weizenyang/3RVX/3d-models/threshold-slope/images/segment_end.png

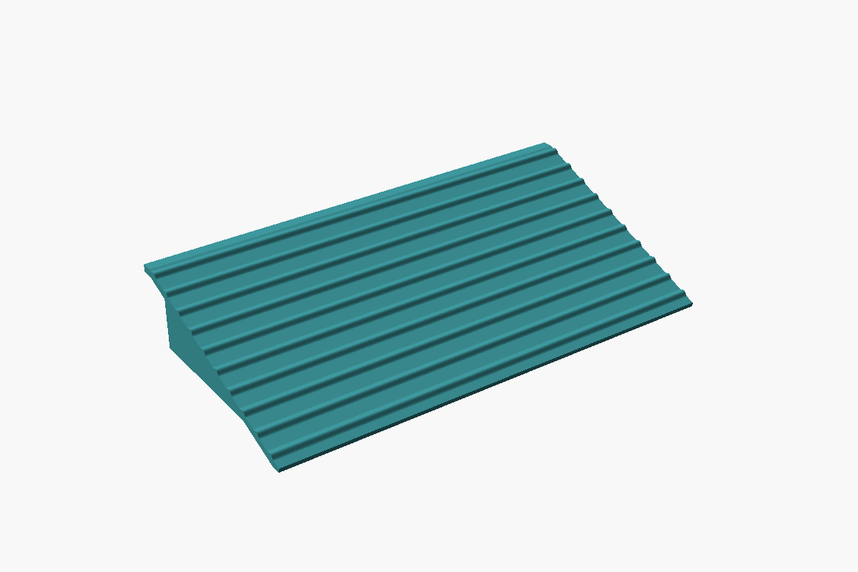
3d-models/threshold-slope/images/segment_end.png
