weizenyang/3RVX/3d-models/threshold-slope/images/segment_underside.png

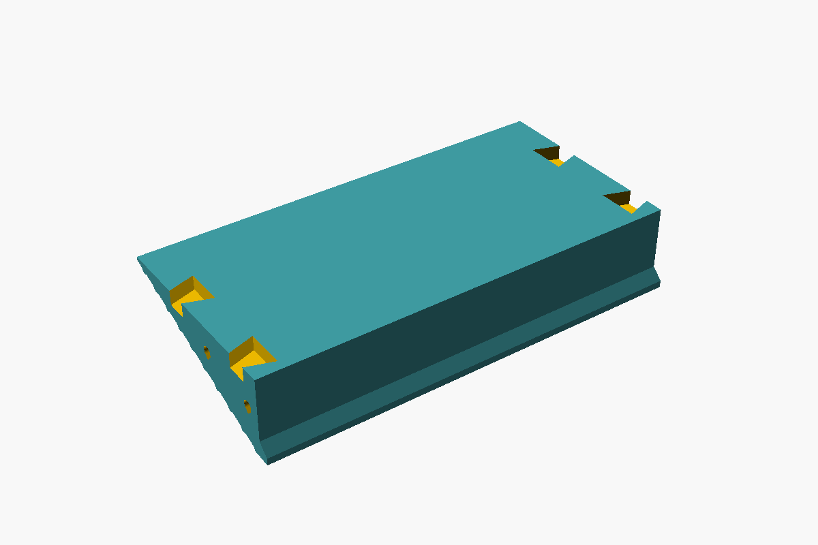
3d-models/threshold-slope/images/segment_underside.png
