weizenyang/3RVX/3d-models/threshold-slope/stl/3-segments/segment_2_of_3.stl

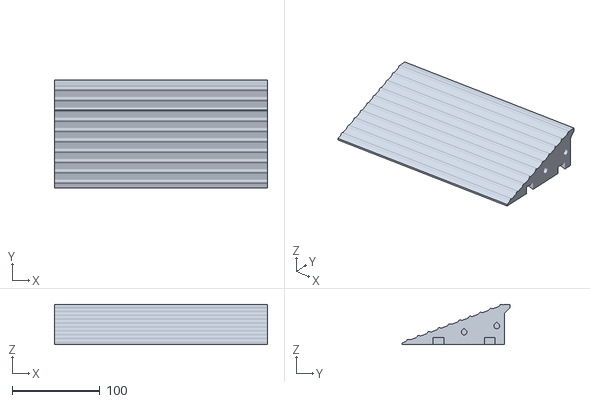
[picture p5: CAD file, 2026-10-03]
3d-models/threshold-slope/stl/3-segments/segment_2_of_3.stl
243.0 x 123.0 x 46.0
