weizenyang/3RVX/3d-models/threshold-slope/stl/3-segments/keys_and_pins.stl

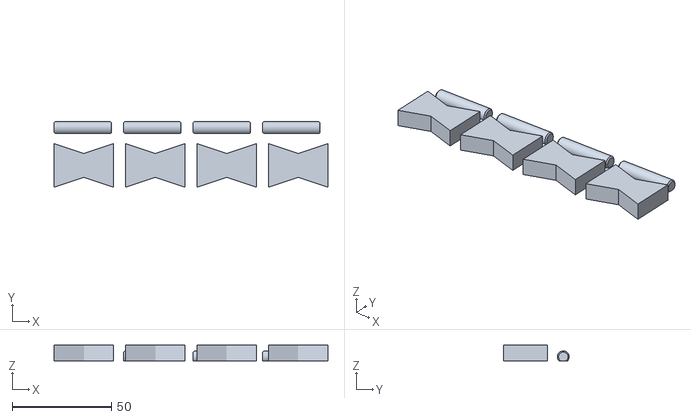
[picture p7: CAD file, 2026-10-03]
3d-models/threshold-slope/stl/3-segments/keys_and_pins.stl
138.0 x 33.0 x 8.00
