weizenyang/3RVX/3d-models/threshold-slope/stl/4-segments/segment_2_of_4.stl

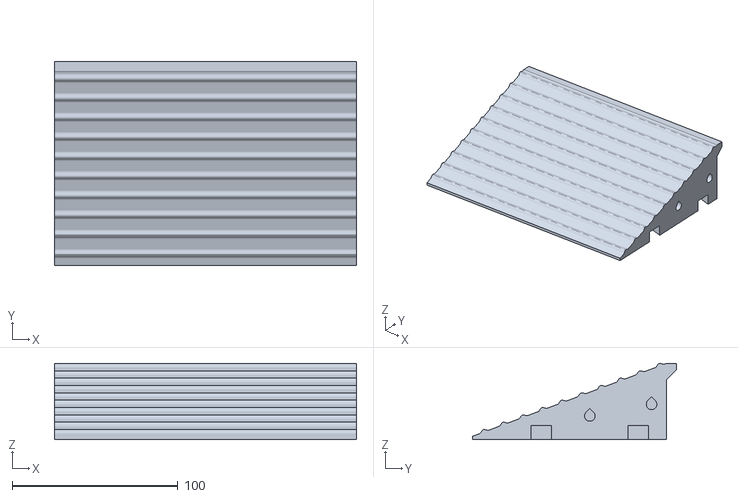
[picture p8: CAD file, 2026-10-03]
3d-models/threshold-slope/stl/4-segments/segment_2_of_4.stl
182.2 x 123.0 x 46.0
