weizenyang/3RVX/3d-models/threshold-slope/stl/4-segments/keys_and_pins.stl

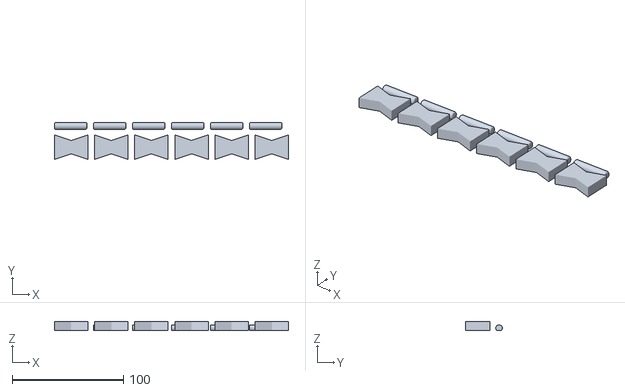
[picture p10: CAD file, 2026-10-03]
3d-models/threshold-slope/stl/4-segments/keys_and_pins.stl
210.0 x 33.0 x 8.00
