weizenyang/3RVX/(list of files, cad)

Other CAD files:
3d-models/threshold-slope/stl/3-segments/segment_3_of_3.stl
3d-models/threshold-slope/stl/4-segments/segment_3_of_4.stl
3d-models/threshold-slope/stl/4-segments/segment_1_of_4.stl
