weizenyang/3RVX/(commit log)

2026-10-03 Add printable 723x120x46 mm threshold slope with wall scribe lips
    Parametric OpenSCAD model of a wedge ramp that slopes down across its
    120 mm depth. The left, right and back sides get a 45-degree chamfered
    scribe lip that overhangs the nominal wall line by 3 mm for trimming to
    uneven walls, with the body held 3 mm off each wall.
    The 723 mm length is split into 3 (250 mm beds) or 4 (220 mm beds)
    segments joined by glued bow-tie keys and teardrop-hole alignment pins.
    Includes exported STLs, preview images, a build script, and print,
    fitting and load notes.
    Claude-Session: https://claude.ai/code/session_01UUmAX72UCkmaHZkJJaWWWV
    [keys_and_pins.stl, segment_1_of_3.stl, segment_1_of_4.stl, segment_2_of_3.stl, segment_2_of_4.stl, segment_3_of_3.stl, segment_3_of_4.stl, segment_4_of_4.stl]
2026-10-03 Threshold slope: raised rounded grip ribs, side-lip view, ASA guidance
    Replace the cut grooves with 10 raised ribs (1.5 x 6 mm, ~12.5 mm pitch)
    using a raised-cosine profile that blends into the slope with no inside
    corner, so there is nowhere for dirt to collect. The top rib's crest
    stays below the 46 mm edge, and an assert rejects rib sizes that would
    undercut on the downhill side.
    Add an end_section preview part and image showing the side scribe lip
    on the end pieces, and document ASA as the sunlight-resistant material
    with PETG as the no-enclosure fallback.
    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
    [keys_and_pins.stl, segment_1_of_3.stl, segment_1_of_4.stl, segment_2_of_3.stl, segment_2_of_4.stl, segment_3_of_3.stl, segment_3_of_4.stl, segment_4_of_4.stl]
